wltj/smart_pid_control/doc/MCU原理图.png

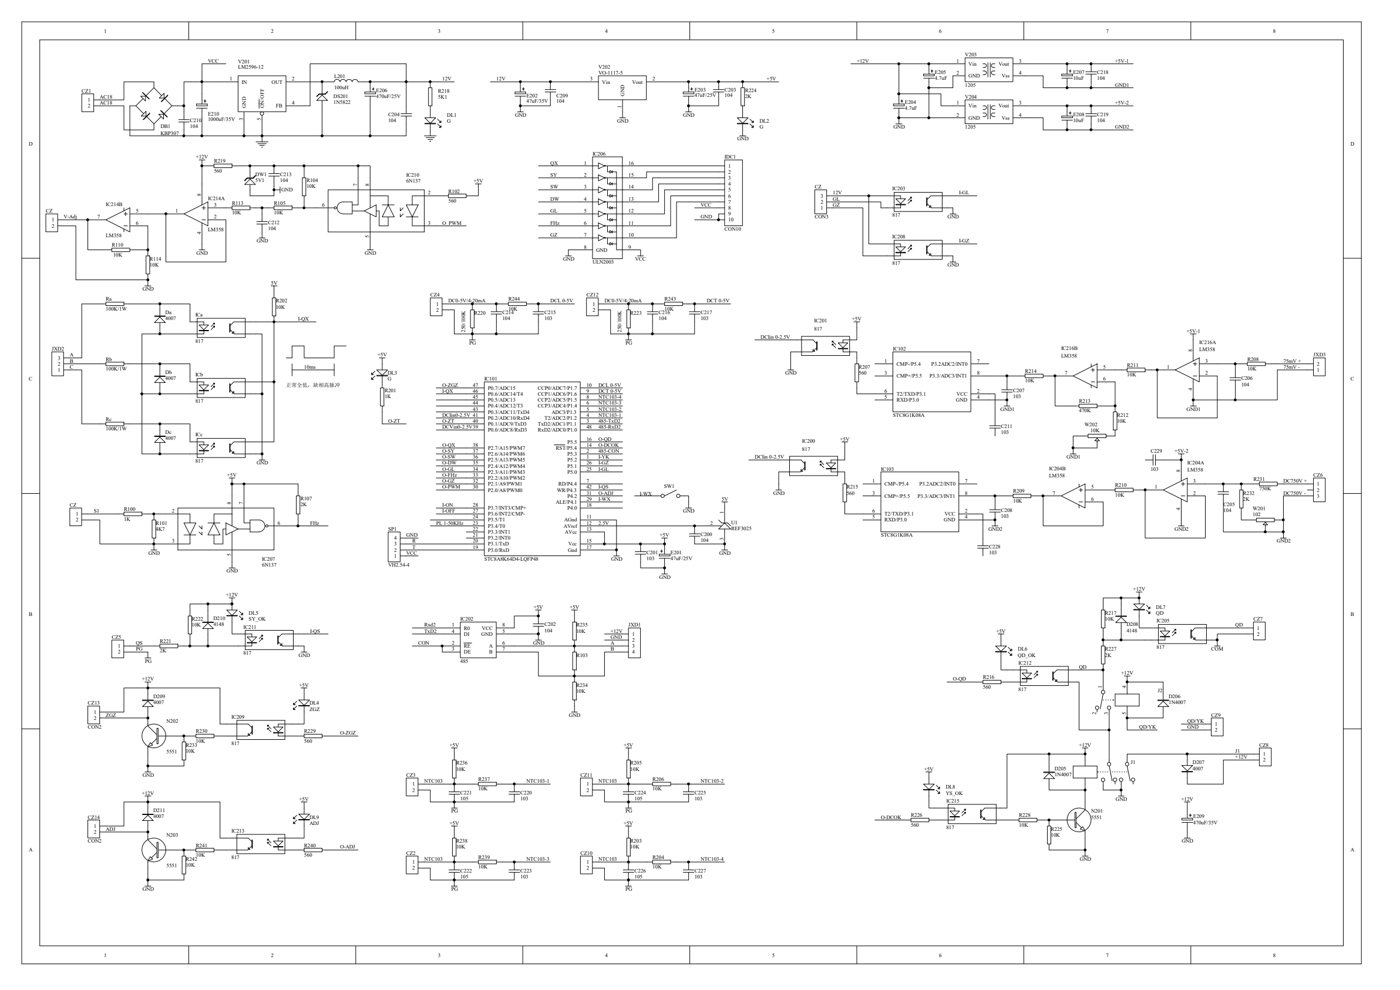
doc/MCU原理图.png
