wltj/smart_pid_control/doc/功能标注.png

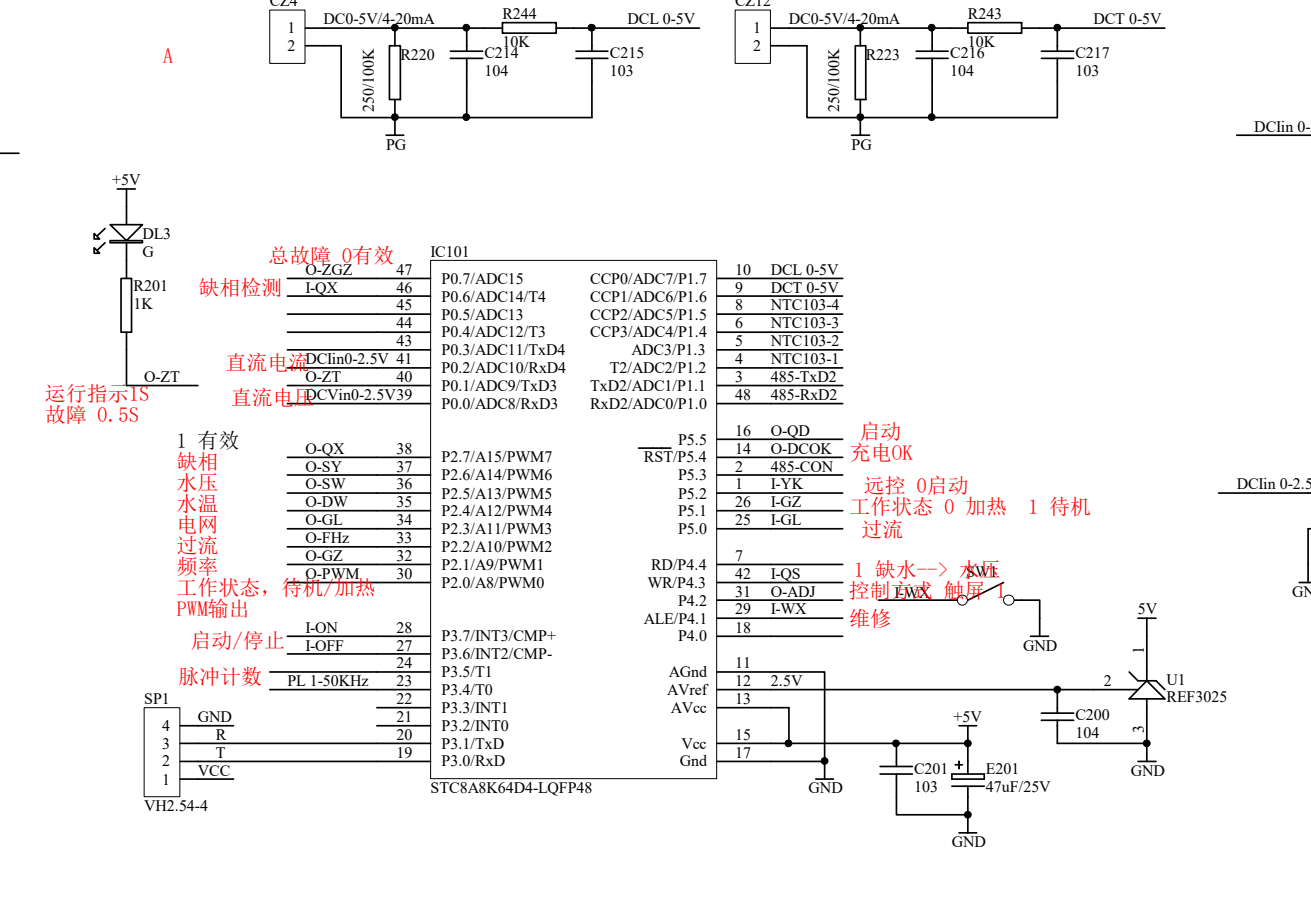
doc/功能标注.png
