wltj/smart_pid_control/doc/MCU原理图.pdf

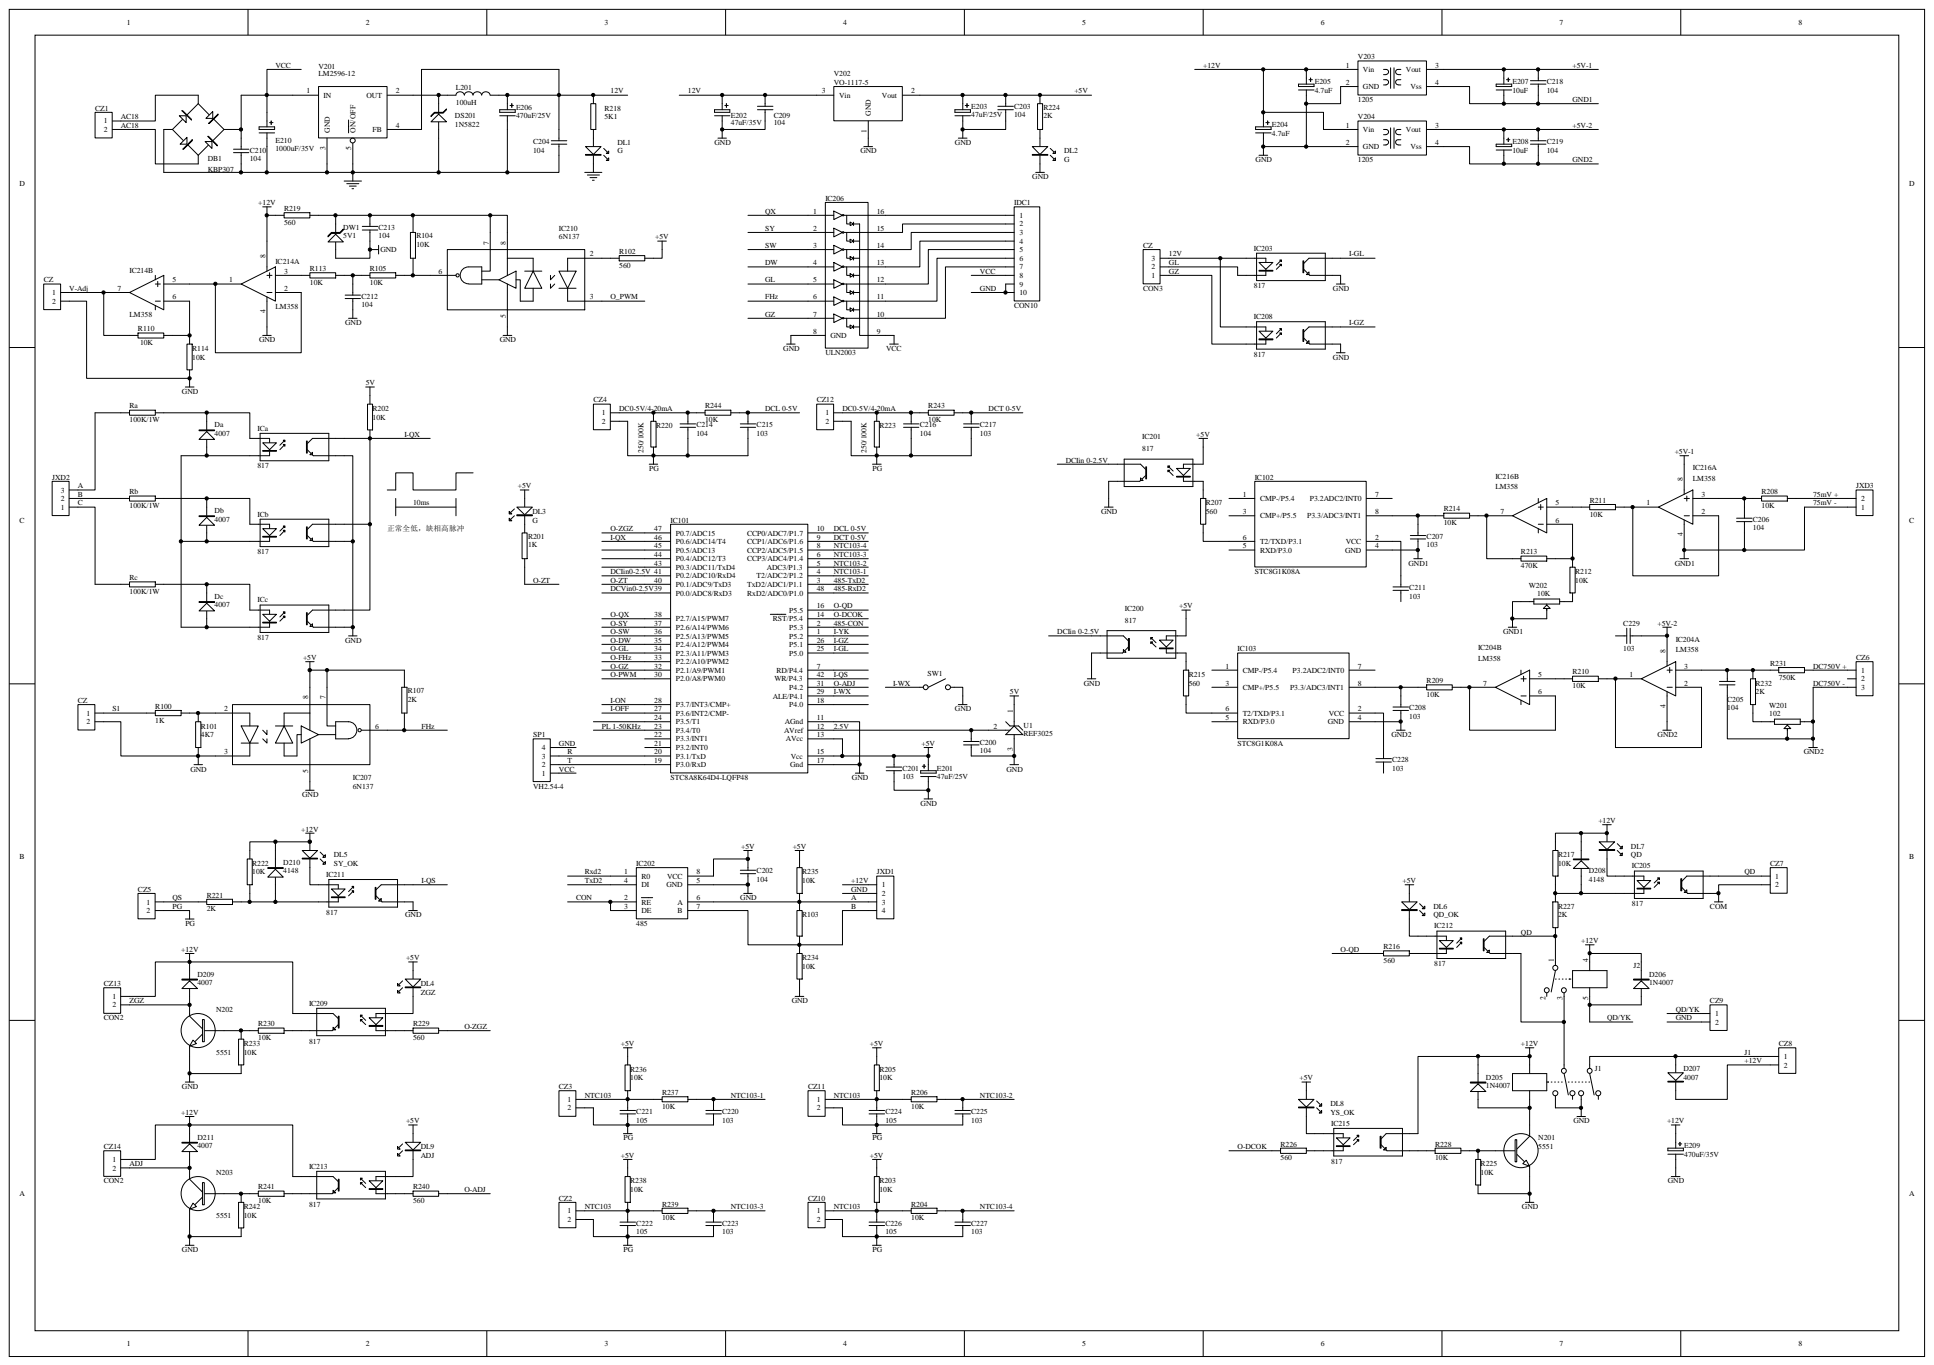
[picture p3: page 1]
