wltj/smart_pid_control/debugUart.c

#include "debugUart.h"
#include "STC8A8K64D4.H"


void init_debug_uart()  //9600bps@11.0592MHz
{		
	PCON &= 0x7F;		//波特率不倍速
	SCON = 0x50;		//8位数据,可变波特率
	AUXR |= 0x40;		//定时器1时钟为Fosc,即1T
	AUXR &= 0xFE;		//串口1选择定时器1为波特率发生器
	TMOD &= 0x0F;		//清除定时器1模式位
	TMOD |= 0x20;		//设定定时器1为8位自动重装方式
	TL1 = 0xDC;		//设定定时初值
	TH1 = 0xDC;		//设定定时器重装值
	ET1 = 0;		//禁止定时器1中断
	TR1 = 1;		//启动定时器1
	
	//ES = 1;    //开串口中断
	
}

/*=========================================================================
  调试串口输出（UART1）
=========================================================================*/
void debug_uart_puts(char *str)
{
	while (*str != '\0') {
		TI = 0;
		SBUF = *str++;
		while (TI == 0);
	}
}

void debug_out(char *msg)
{
	while (*msg != '\0') {
		TI = 0;
		SBUF = *msg++;
		while (TI == 0);
	}
}
