wltj/smart_pid_control/(commit log)

2026-07-08 首次提交
2026-07-08 添加adc相关功能
2026-07-08 功能添加完成
2026-07-09 功能逻辑移植
2026-07-09 优化掉点保存，测试不好用
2026-07-09 修正部分地址
2026-07-09 实现频率更新
2026-07-09 修正工作状态判断方式
2026-07-09 实现运行控制
2026-07-09 实现远控按钮逻辑
2026-07-09 添加调试上位机
2026-07-09 地址已测试完成
2026-07-09 增加调试模式
2026-07-14 适配屏幕的数据发送方式
2026-07-14 温度NTC
2026-07-16 修复ADC读取温度，未测试
2026-07-16 重构PID
2026-07-17 添加日志文件
2026-07-24 ADC读取温度修复，待测试
2026-07-24 外部输入检测消抖
2026-07-24 修正缺相检测判断方法
2026-07-24 增加测试说明文档
2026-07-24 修改初始化引脚
2026-07-24 adc串口通讯调试通过
2026-07-24 修复串口adc值
